UzixLS/zx-sizif-512-wifi/README.md

## WiFi module for Sizif-512

For software see [here](https://github.com/nihirash/zx-net-tools)
