UzixLS/zx-sizif-512-wifi/out/pcb3d.png

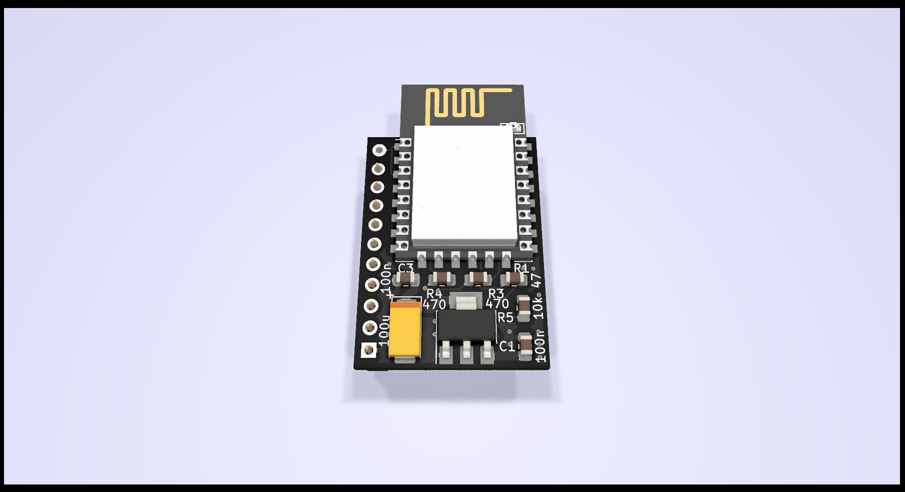
out/pcb3d.png
