UzixLS/zx-sizif-512-wifi/out/bom.pdf

Designator | Package | Designation | Quantity
C2 | CP_EIA-6032-15_Kemet-U_Pad2.25x2.35mm_HandSolder | 100u | 1
C3,C1 | C_0805_2012Metric_Pad1.15x1.40mm_HandSolder | 100n | 2
J1 | PinSocket_1x10_P2.54mm_Vertical | Conn_01x10 | 1
R1 | C_0805_2012Metric_Pad1.15x1.40mm_HandSolder | 47 | 1
R3,R4 | C_0805_2012Metric_Pad1.15x1.40mm_HandSolder | 470 | 2
R5 | C_0805_2012Metric_Pad1.15x1.40mm_HandSolder | 10k | 1
U1 | SOT-223-3_TabPin2 | AMS1117-3.3 | 1
U2 | ESP-12E | ESP-12E | 1
