UzixLS/zx-sizif-512-wifi/out/schematic.pdf

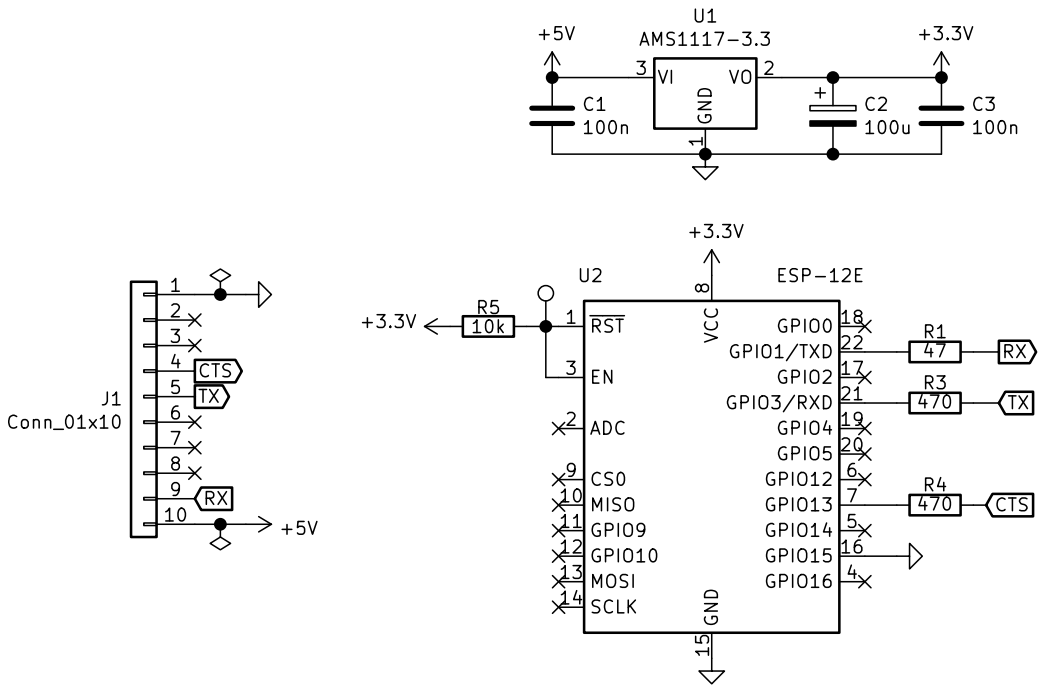
[picture p2: page 1]

1 VO 2 VI 3 U1 AMS1117-3.3 +3.3V RST 1 MISO 10 GPIO9 11 GPIO10 12 MOSI 13 SCLK 14 GND 15 GPIO15 16 GPIO2 17 GPIO0 18 GPIO4 19 ADC 2 GPIO5 20 GPIO3/RXD 21 GPIO1/TXD 22 EN 3 GPIO16 4 GPIO14 5 GPIO12 6 GPIO13 7 VCC

File: sizif512-wifi.sch Sheet: /
Id: 1/1 Title: WiFi module for SIZIF-512
