UzixLS/zx-sizif-512-wifi/out/assembly.pdf

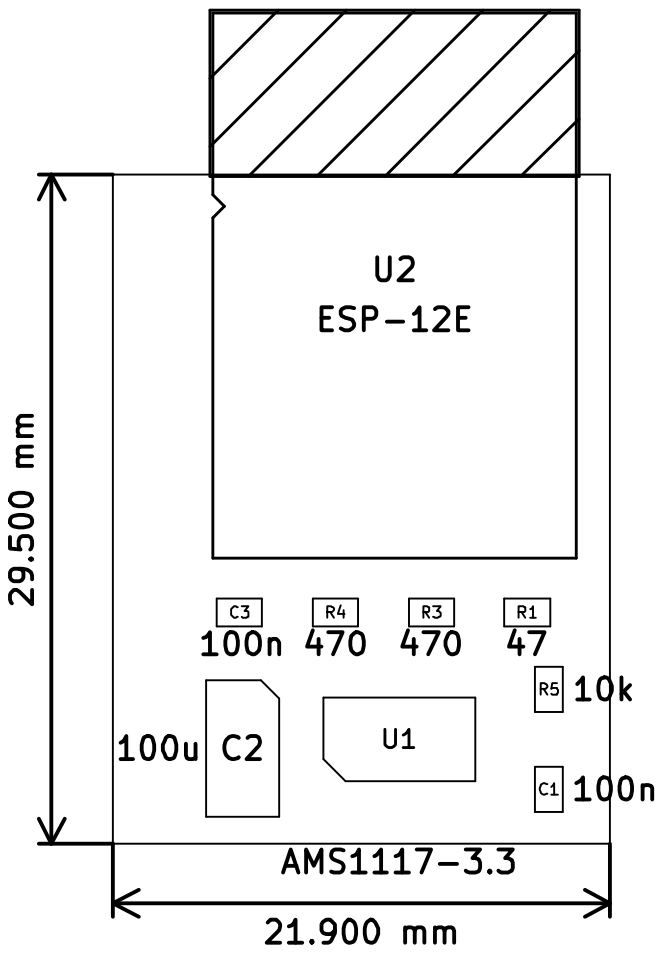
[picture p3: page 1]

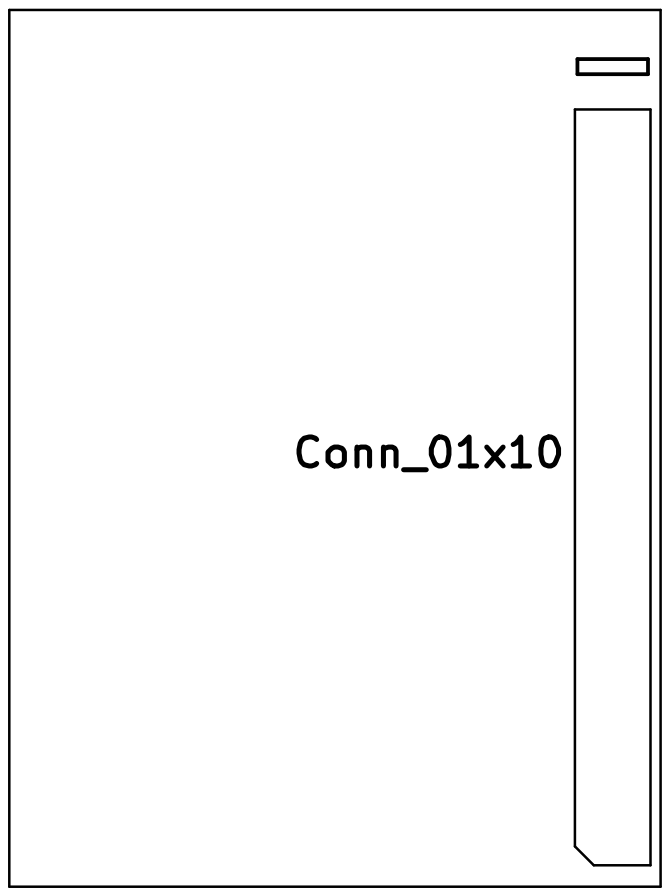
[picture p4: page 2]
