UzixLS/zx-sizif-512-wifi/pcb/sizif512-wifi.kicad_pcb

## KiCad design pcb/sizif512-wifi.kicad_pcb (2021-02-27)

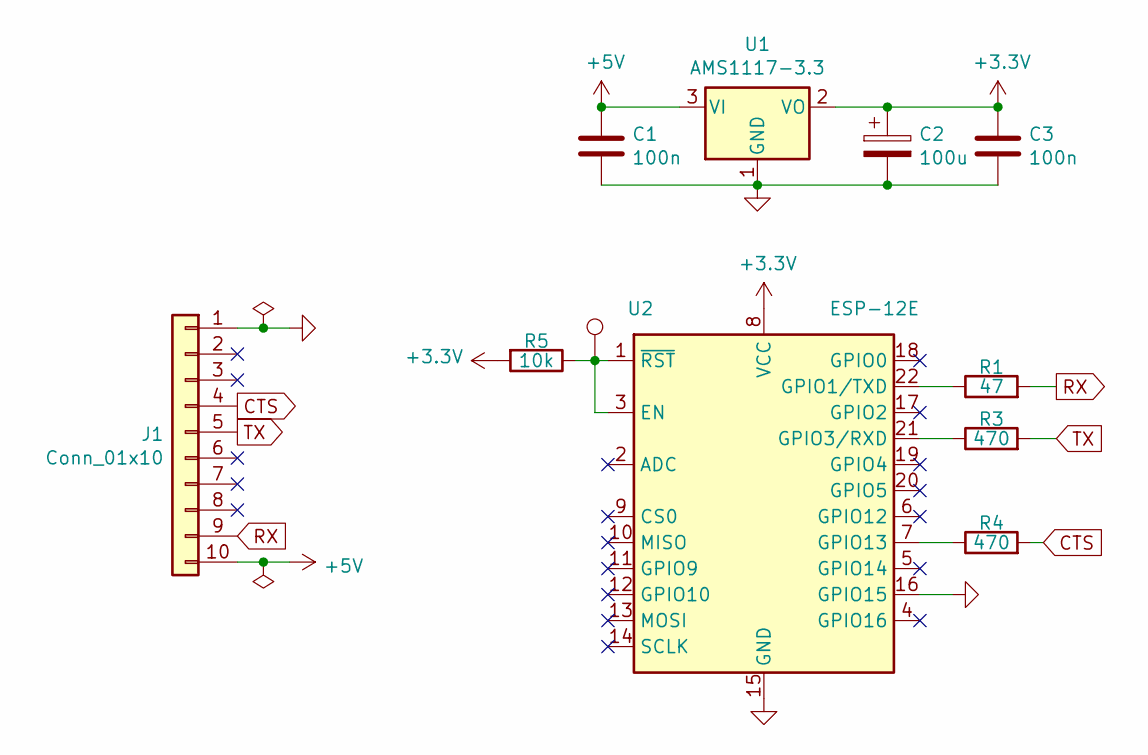
[picture p5: schematic sizif512-wifi.sch, WiFi module for SIZIF-512]

Parts:
C1, C3: 100n; C_0805_2012Metric_Pad1.15x1.40mm_HandSolder
C2: 100u; CP_EIA-6032-15_Kemet-U_Pad2.25x2.35mm_HandSolder
J1: Conn_01x10; PinSocket_1x10_P2.54mm_Vertical
R1: 47; C_0805_2012Metric_Pad1.15x1.40mm_HandSolder
R3, R4: 470; C_0805_2012Metric_Pad1.15x1.40mm_HandSolder
R5: 10k; C_0805_2012Metric_Pad1.15x1.40mm_HandSolder
TP1: TestPoint; Pin_D0.9mm_L10.0mm_W2.4mm_FlatFork
U1: AMS1117-3.3; SOT-223-3_TabPin2
U2: ESP-12E

Connections:
+3V3: C2.1, C3.1, R5.2, U1.2 (VO), U2.8 (VCC)
+5V: C1.1, J1.10, U1.3 (VI)
CTS: J1.4, R4.2
GND: C1.2, C2.2, C3.2, J1.1, U1.1 (GND), U2.15 (GND), U2.16 (GPIO15)
unnamed: R1.1, U2.22 (GPIO1/TXD)
unnamed: R3.1, U2.21 (GPIO3/RXD)
unnamed: R4.1, U2.7 (GPIO13)
unnamed: R5.1, TP1.1, U2.1 (~RST), U2.3 (EN)
RX: J1.9, R1.2
TX: J1.5, R3.2

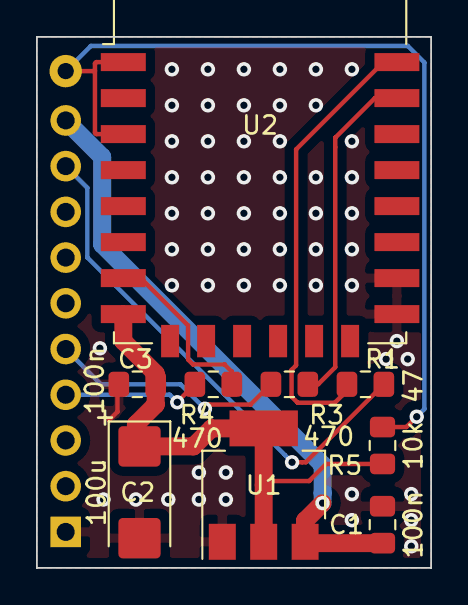
[picture p6: board sizif512-wifi.kicad_pcb from above]

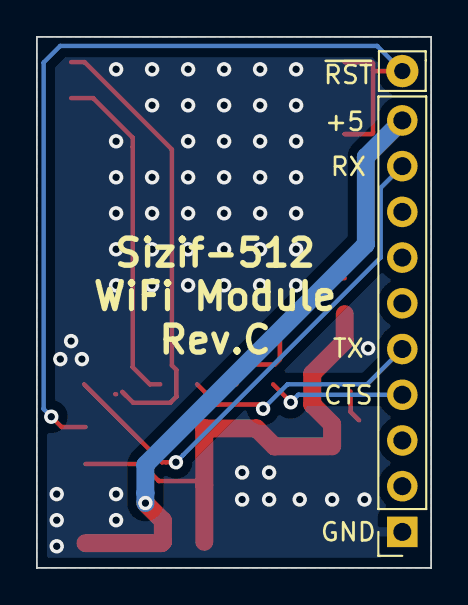
[picture p7: board sizif512-wifi.kicad_pcb from below]

Board: 2 copper layers, 21.9 x 29.5 mm, 11 parts (2 on the bottom side), 10 nets.
