UzixLS/zx-sizif-512-wifi/(commit log)

2020-07-06 import rev.A files
    [sizif512-wifi.kicad_pcb, sizif512-wifi.sch]
2020-07-06 import rev B files
    [sizif512-wifi.kicad_pcb, sizif512-wifi.sch]
2021-02-27 import rev C files
    [sizif512-wifi.kicad_pcb, sizif512-wifi.sch]
